N2-Sumikko/HalfCliff/doc/option_jp.md

こちらはHalfcliffのオプションの部品用の資料です。(2022/1/4時点では作成中の資料です。対応完了、と書かれたもの以外は使用不可です。)

対応を予定しているオプションの部品は以下の通りです。
設計時の制約によっては、対応を断念する可能性もあります。
* (対応完了。随時追記)ロータリーエンコーダ
* (現状は左キーボードのみ対応完了。部品は準備中)ビットトレードワン製トラックボール(ADTB7M)
* (対応完了。随時追記)OLED
* (動作確認予定)BLE Micro Pro
* (試作品作成完了)直交配列拡張基板
* (設計予定)英字配列風拡張基板
* (必要に応じて資料作成予定)右キーボードのテンキーとしての組立

# ロータリーエンコーダ
基板のフットプリントに対応しているロータリーエンコーダが使用可能です。(プッシュ機能には未対応です。)

実機にて動作確認済のものは以下の通りです。
* PEC12R-4222F-S0024(遊舎工房様等で購入可能)
* EC12E2430803(秋月電子様等で購入可能)

## 必要な部品の用意
以下の部品を用意します。

|名前|合計数|備考|
|:-|:-|:-|
|ロータリーエンコーダ|1個||
|ロータリーエンコーダ用ノブ|1個||

## 使用時の主な注意点
* 組立済みのキーボードにロータリーエンコーダを取付ける場合、取付け箇所のキースイッチを(はんだを除去して)取外す必要があります。
* ロータリーエンコーダのプッシュ機能は未対応です。
* ロータリーエンコーダ使用時は、対応するファームウェアの書込みが必要です。
* 操作時の動作を変更する際は、QMK MSYSまたはRemap、VIAを使用する必要があります。Remap、VIAを使用する場合、ロータリーエンコーダを上から見て時計回りに回転させた時の動作は、ロータリーエンコーダを取付けた列の一番上のキーと同じになります。
* (β版のみ)ロータリーエンコーダ取付け時に端子とトッププレートが干渉する場合、端子の位置や角度を干渉しないように調整するか、トッププレートの干渉部分を削る必要があります。

## 取付け方法

おおまかな作業順序
* (キースイッチはんだ付け済みの場合)ロータリーエンコーダ取付箇所のキースイッチの取外し
* ロータリーエンコーダの取付、はんだ付け(β版は注意点有り)
* (QMK Toolboxを使用する場合)ロータリーエンコーダ対応のファームウェアの書込み
* (QMK MSYSを使用する場合)ロータリーエンコーダ対応のファームウェアの書込み

## (キースイッチはんだ付け済みの場合)ロータリーエンコーダ取付箇所のキースイッチの取外し
ロータリーエンコーダ取付箇所(左右キーボード共に、一番内側の上から四番目のキーの位置)

にキースイッチがある場合は(はんだを除去して)取外します。ない場合はこの手順は飛ばします。

まずは取付を行うキーボードを裏返し、キースイッチ基板及び拡張基板をボトムプレートに固定しているねじを取外します。

左キーボードのねじ取外し箇所(黄丸で示したねじを取外します。右キーボードの場合も同じイメージです。)
ねじ取外し_ロータリーエンコーダ取付時

ねじを取外したら、キースイッチ基板と拡張基板をProMicro基板の反対方向にスライドさせて取外します。この時、ProMicro基板とキースイッチ基板を接続しているピンになるべく負荷をかけないよう注意します。

左キーボードの取外しのイメージ(水色の矢印の向きにスライドさせます。右キーボードの場合は逆方向です。)

キースイッチ基板取外し_ロータリーエンコーダ取付時

取外し後、ロータリーエンコーダ取付箇所のキースイッチのはんだをはんだ吸取機等で取り除き、取外します。

左キーボードでの取外し箇所(画像の黄丸の部分のはんだを除去し、キースイッチを取外します。右キーボードの場合も、一番内側の上から四番目のキーのはんだを同じ様に除去します。)

キースイッチ取外し箇所

## ロータリーエンコーダの取付、はんだ付け(β版の場合注意点有り)

ロータリーエンコーダを取付け、はんだ付けします。はんだ付けを行う箇所は画像の黄枠の部分です。(水色枠の部分のはんだ付けは任意です。)
ロータリーエンコーダ用はんだ付け箇所

(β版の場合)画像の様に、ロータリーエンコーダの端子(特に端子が3本ある方)とトッププレートが干渉することがあります。


その場合、トッププレートの干渉部分を削るか、ロータリーエンコーダの端子を下の画像の様に(半分より下を外側に広げるように)曲げて取付けます。


取付後の画像


## キースイッチ基板、拡張基板の再取付

取外しとは逆の手順で、キースイッチ基板とProMicro基板を接続し、キースイッチ基板と拡張基板をボトムプレートへねじ止めします。

取付後、キースイッチ基板と拡張基板を接続しているジャンパピンの状態を確認します。ピンヘッダとの接続が甘くなっていたり、外れている場合は取付け直します。

## (QMK Toolboxを使用する場合)ロータリーエンコーダ対応のファームウェアの書込み
キーボード組立時に行った
[入力動作テスト](https://github.com/N2-Sumikko/HalfCliff/blob/master/doc/Oparation_test_jp.md)
の内容を参考に、QMK ToolboxにてHexファイルを書込みます。

現時点で使用可能なロータリーエンコーダ対応のHexファイルは以下の通りです。いずれもロータリーエンコーダの機能はVIA、Remapにて変更可能です。

QMKにマージされたファームウェアを変更して作成したものは(unofficial)と記載しています。いずれも動作確認済です。(もし動作に問題があった場合はご連絡いただけると助かります。)

|フォルダ|ファイル名|概要|
|:-|:-|:-|
|hex/qmk_0.15.4/via/others/(unofficial)oled_encoder_trackball_mousekey/|halfcliff_via.hex|OLEDとロータリーエンコーダとトラックボール使用時です。|
|hex/qmk_0.15.4/via/others/(unofficial)encoder_trackball_mousekey/|halfcliff_via.hex|トラックボールとロータリーエンコーダ使用時です。|
|hex/qmk_0.15.4/via/others/(unofficial)oled_encoder/|halfcliff_via.hex|OLED、ロータリーエンコーダ使用時用です。|
|hex/qmk_0.15.4/via/others/(unofficial)encoder/|halfcliff_via.hex|ロータリーエンコーダ使用時用です。|

## (QMK MSYSを使用する場合)ロータリーエンコーダ対応のファームウェアの書込み
必要に応じて追記する予定です。

# ビットトレードワン製トラックボール(ADTB7M)
のぎけす屋様のトラックボールモジュール用レベル変換基板の使用により、ビットトレードワン製トラックボール(ADTB7M)が使用可能です。

## 必要な部品の用意
以下の部品を用意します。(トラックボールモジュール取付用キットが用意出来ていないので、現時点では参考程度の情報となります。β版を購入された方で、取付をご希望されている方がおりましたら、お手数ですがご連絡いただければと思います。)
|名前|合計数|備考|
|:-|:-|:-|
|7mmオプティカルトラックボールモジュール１uタイプ|1個|[ビット・トレード・ワン様のトラックボールモジュール(型番：ADTB7M)](https://bit-trade-one.co.jp/selfmadekb/adtb7m/)です。以下、トラックボールモジュールと呼びます。|
|トラックボールモジュール用レベル変換基板|1個|のぎけす屋様のトラックボールモジュール用レベル変換基板です。以下、変換基板と呼びます。|
|トラックボールモジュール用トッププレート|1個|トラックボールモジュール取付用キットに同梱の部品です。|
|トラックボールモジュール用ボトムプレート|1個|トラックボールモジュール取付用キットに同梱の部品です。|
|M2x6mmスペーサー|2本|トラックボールモジュール取付用キットに同梱の部品です。|
|M2x4mmスペーサー|2本|トラックボールモジュール取付用キットに同梱の部品です。|
|M2x10mmねじ|2本|トラックボールモジュール取付用キットに同梱の部品です。|
|M2x4mmねじ|2本|トラックボールモジュール取付用キットに同梱の部品です。|

トラックボールモジュール、変換基板は遊舎工房様の実店舗、[通販サイト](https://yushakobo.jp/shop/)等で購入可能です。

トラックボールモジュール取付用キットは用意出来次第、何らかの形で販売する予定です。

## 使用時の主な注意点
* キーボード組立時にキースイッチ基板にロープロファイルピンソケット1x4をはんだ付けしていない場合、トラックボールモジュールの取付は基本的に不可です。ご注意ください。
　(完全に不可能ではありませんが、とても長いピンヘッダを使用するなど、特殊な取付方法が必要です。試したら追記します。）
* halfcliffにてトラックボールを使用する場合、通常のファームウェア(本資料に記載のHexファイル)ではトラックボールを左キーボードに取付けた時のみ正しく動作します。右キーボードにトラックボールを取付けたい場合は、右キーボードへのUSBケーブル接続時に正常動作するファームウェアの書込みが必要です。(具体的には、config.hに#define MASTER_RIGHTを追記してコンパイルしたファームウェア等です。)
* トラックボールモジュールの配線及びピンヘッダを変換基板にはんだ付けする際は、各部品の向きにご注意ください。
* アクリル製の部品にスペーサーの取付けやねじ止めをする際は、強い力をかけると破損の恐れがあるのでご注意ください。

## 取付け方法

おおまかな作業順序
* (キースイッチはんだ付け済みの場合)トラックボールモジュール取付箇所のキースイッチの取外し
* 変換基板へのトラックボールモジュール配線、ピンヘッダ1x4のはんだ付け
* トラックボールモジュール用ボトムプレートの四角い穴へ変換基板の配線を通す
* トッププレートにM2x4㎜スペーサー2つをM2x10mmねじ2本で取付け
* キースイッチ基板のロープロファイルピンソケット1x4へ変換基板のピンヘッダ1x4を取付け
* M2x10mmねじへのトラックボールモジュール用ボトムプレートの取付け
* M2x6mmスペーサ2つをM2x10mmねじにねじ止めしてトラックボール用ボトムプレートを固定
* トラックボールモジュールの配線位置を調整して、トラックボールモジュール用ボトムプレートの上にトラックボールモジュールを置けるようにする
* トラックボールモジュール用トッププレートをM2x4mmねじ2本で固定
* (QMK Toolboxを使用する場合)トラックボールモジュール対応のHexファイルの書込み
* (QMK MSYSを使用する場合。ちょっと大変)トラックボールモジュール対応のファームウェアの書込み

トラックボールモジュール対応のファームウェアの内容に関しては、[こちら](https://github.com/sekigon-gonnoc/qmk_firmware/tree/dev/ble_micro_pro/keyboards/helix/rev2/keymaps/bto_tb)のせきごん様のリンクも参考になるかと思います。

## (キースイッチはんだ付け済みの場合)トラックボールモジュール取付箇所のキースイッチの取外し

トラックボール取付箇所(左右共に、一番内側の、一番上のキーの位置)

にキースイッチがある場合は(はんだを除去して)取外します。ない場合はこの手順は飛ばします。

まずは取付を行うキーボードを裏返し、キースイッチ基板、拡張基板をボトムプレートに固定しているねじを取外します。

左キーボードのねじ取外し箇所(黄丸で示したねじを取外します。)
ねじ取外し_ロータリーエンコーダ取付時

ねじを取外したら、キースイッチ基板と拡張基板をProMicro基板の反対方向にスライドさせて取外します。この時、ProMicro基板とキースイッチ基板を接続しているピンになるべく負荷をかけないよう注意します。

左キーボードの取外しのイメージ(水色の矢印の向きにスライドさせます。)

キースイッチ基板取外し_ロータリーエンコーダ取付時

取外し後、トラックボールモジュール取付箇所のキースイッチのはんだをはんだ吸取機等で取り除き、取外します。

左キーボードでの取外し箇所(黄丸の部分のはんだを除去し、キースイッチを取外します。)

トラックボール取付時のキースイッチ取外し箇所

## 変換基板へのトラックボールモジュール配線、ピンヘッダ1x4のはんだ付け

画像のように、変換基板へトラックボールモジュールの配線と、ピンヘッダ1x4をはんだ付けします。各部品の向きに注意して下さい。

言葉で説明すると、トラックボールモジュールの配線がある面を自分の方に向けて、変換基板の部品がある面を下、かつ部品が無い面の文字を自分から見て正しい向きにした状態で、部品が無い面からある面へ配線を通します。

その後、画像を参考にしながら部品がある面の長方形のパッドにそれぞれの配線をはんだ付けします。

ピンヘッダ1x4については、ピンヘッダの短い方が変換基板側、かつピンヘッダの樹脂部分が変換基板の部品がある面に来るようにして、四角形のランドにピンが入るように取付けてはんだ付けします。(四角形のランドから一番遠い丸いランドにピンが入らないようにします。)



変換基板を裏返した写真(長方形のパッドへのはんだ付け参考用)


## トラックボールモジュール用ボトムプレートの四角い穴へ変換基板の配線を通す

トラックボールモジュール用ボトムプレートの保護シートがある場合ははがします。

その後画像の様に、トラックボールモジュール用ボトムプレートの四角い穴へ、トラックボールモジュールの配線を通します。



## トッププレートにM2x4㎜スペーサー2つをM2x10mmねじ2本で取付け

画像の様に、トッププレートのU字の切り欠き2箇所に、M2x10mmねじ2本でM2x4㎜スペーサー2つを取付けます。

(説明のため、左キーボードのProMicroカバーや一部のキーキャップを取外してあります。)



## キースイッチ基板のロープロファイルピンソケット1x4へ変換基板のピンヘッダ1x4を取付け

画像の様に、キースイッチ基板のロープロファイルピンソケット1x4に、キースイッチ基板のトッププレートを介して変換基板のピンヘッダ1x4を取付けます。



## M2x10mmねじへのトラックボールモジュール用ボトムプレートの取付け

画像の様に、トラックボールモジュール用ボトムプレートの穴にM2x10mmねじ2本を通すようにして取付けます。



## M2x6mmスペーサ2つをM2x10mmねじにねじ止めしてトラックボール用ボトムプレートを固定

M2x10mmねじ2本にM2x6㎜スペーサー2つをトラックボールモジュール用ボトムプレートの上から取付け、トラックボールモジュール用ボトムプレートを固定します。



## トラックボールモジュールの配線位置を調整して、トラックボールモジュール用ボトムプレートの上にトラックボールモジュールを置けるようにする

画像を参考にトラックボールモジュールの配線位置を調整して、ボトムプレートの上にトラックボールモジュールを置けるようにします。


## トラックボールモジュール用トッププレートをM2x4mmねじ2本で固定

トラックボールモジュールの位置を調整しながら、M2x6mmスペーサ2つにトラックボールモジュール用トッププレートをM2x4mmねじ2本でねじ止めします。



## (QMK Toolboxを使用する場合)トラックボールモジュール対応のHexファイルの書込み

キーボード組立時に行った
[入力動作テスト](https://github.com/N2-Sumikko/HalfCliff/blob/master/doc/Oparation_test_jp.md)
の内容を参考に、QMK ToolboxにてHexファイルを書込みます。

現時点で使用可能なトラックボール対応のHexファイルは以下の通りです。ロータリーエンコーダ対応のファームウェアの場合、ロータリーエンコーダの機能はVIA、Remapにて変更可能です。

QMKにマージされたファームウェアを変更して作成したものは(unofficial)と記載しています。いずれも動作確認済です。

|フォルダ|ファイル名|概要|
|:-|:-|:-|
|hex/qmk_0.15.4/via/others/(unofficial)oled_encoder_trackball_mousekey/|halfcliff_via.hex|OLEDとロータリーエンコーダとトラックボール使用時です。|
|hex/qmk_0.15.4/via/others/(unofficial)encoder_trackball_mousekey/|halfcliff_via.hex|ロータリーエンコーダとトラックボール使用時です。|
|hex/qmk_0.15.4/via/others/(unofficial)trackball_mousekey/|halfcliff_via.hex|トラックボール使用時用です。|

## (QMK MSYSを使用する場合。ちょっと大変)トラックボールモジュール対応のファームウェアの作成、書込み
必要に応じて追記する予定です。(作成のパターンは、ファイルの直接変更か差替えの2パターンがあると考えています。追記する場合は、まずはファイルの差替えの手順を書く予定です。)

# OLED
対応するOLEDの取付が可能です。以下編集中の情報です。

## 必要な部品の用意
以下の部品を用意します。
|名前|合計数|備考|
|:-|:-|:-|
|OLED|2個|[こちら](https://shop.yushakobo.jp/products/oled)、または互換品が使用可能です。ただし全体の厚みに注意です。|
|ピンヘッダ1x4|1個|ピンヘッダの長さに注意が必要です。[PSH-410256-04](https://hirosugi.co.jp/products/N/PSH-41.html)等が使用可能です。|
|M2x2mm中空スペーサー|4個|halfcliffの基本セットに付属の予備のスペーサーが使用可能です。|
|M2x6mmねじ|4本||

## 使用時の主な注意点
* OLEDによっては、基板とディスプレイの間に厚い両面テープがあり、全体の厚みが増していることがあります。そのような場合、中空スペーサーを使用してもOLEDとProMicroカバーが干渉する可能性があります。対策としては、ディスプレイを割らないように気を付けながら両面テープをはがし、薄い両面テープを貼り直す等が有効です。
* OLEDを使用する場合、左右のキーボードにOLEDを取付ける必要があります。
* デフォルトの状態のOLEDにはレイヤーの状態とQMK firmwareのロゴが表示されます。表示内容を変更する場合、QMK MSYS等を使用してファームウェアを変更する必要があります。
* アクリル製の部品にスペーサーの取付けやねじ止めをする際は、強い力をかけると破損の恐れがあるのでご注意ください。

## 取付け方法

大まかな作業順序
* ProMicroカバーの取外し
* OLEDへピンヘッダ1x4のはんだ付け(注意点有り)
* ProMicro基板のロープロファイルピンソケット1x4へのOLEDの取付け、はんだ付け
* M2x2㎜中空スペーサー、ProMicroカバーをM2x6mmねじで取付
* (QMK Toolboxを使用する場合)OLED対応のHexファイルの書込み
* (QMK MSYSを使用する場合)OLED対応のファームウェアの書込み

## ProMicroカバーの取外し
ProMicroカバーを固定しているM2x4mmねじ2本を緩め、ProMicroカバーを取外します。左右のキーボードに対して同様の作業を実施します。

## OLEDへピンヘッダ1x4の取付け、はんだ付け(注意点有り)

OLEDへピンヘッダ1x4を取付け、はんだ付けします。

(注意点)ProMicro基板のロープロファイルピンソケット1x4へOLEDのピンヘッダ1x4を取付ける際には、ある程度の高さが必要です。(具体的には、OLEDの基板底面から樹脂部分含めて9㎜弱の長さが必要です。[こちら](https://hirosugi.co.jp/products/N/PSH-41.html)等が使用可能です。

## ProMicro基板のロープロファイルピンソケット1x4へのOLEDの取付け

ProMicro基板のロープロファイルピンソケット1x4へ、OLEDにはんだ付けしたピンヘッダ1x4を取付けます。

## M2x2㎜中空スペーサー、ProMicroカバーをM2x6mmねじで取付

ProMicro基板を固定していたM2x7mmスペーサー2つの上にM2x2mm中空スペーサーをそれぞれ置きます。左右のキーボードに対して同様の作業を実施します。

(画像はトラックボール、ロータリーエンコーダを取付けした状態の左キーボードです。)


その後、M2x6mmねじ2本を、ProMicroカバー、中空スペーサーの穴の順に通してM2x7mmスペーサーへねじ止めします。



## (QMK Toolboxを使用する場合))OLED対応のHexファイルの書込み
キーボード組立時に行った
[入力動作テスト](https://github.com/N2-Sumikko/HalfCliff/blob/master/doc/Oparation_test_jp.md)
の内容を参考に、QMK ToolboxにてHexファイルを書込みます。

現在使用可能なOLED対応のHexファイルは以下の通りです。ロータリーエンコーダ対応のファームウェアの場合、ロータリーエンコーダの機能はVIA、Remapにて変更可能です。

QMKにマージされたファームウェアを変更して作成したものは(unofficial)と記載しています。いずれも動作確認済です。

|フォルダ|ファイル名|概要|
|:-|:-|:-|
|hex/qmk_0.15.4/via/others/(unofficial)oled_encoder_trackball_mousekey/|halfcliff_via.hex|OLEDとロータリーエンコーダとトラックボール使用時です。|
|hex/qmk_0.15.4/via/others/(unofficial)oled_trackball_mousekey/|halfcliff_via.hex|OLED、トラックボール使用時です。|
|hex/qmk_0.15.4/via/others/(unofficial)oled_encoder/|halfcliff_via.hex|OLEDとロータリーエンコーダ使用時用です。|
|hex/qmk_0.15.4/via/others/(unofficial)oled/|halfcliff_via.hex|OLED使用時用です。|

## (QMK MSYSを使用する場合)OLED対応のファームウェアの書込み
必要に応じて追記する予定です。
