N2-Sumikko/HalfCliff/data/plate/dxf/promicro_coverplate.dxf

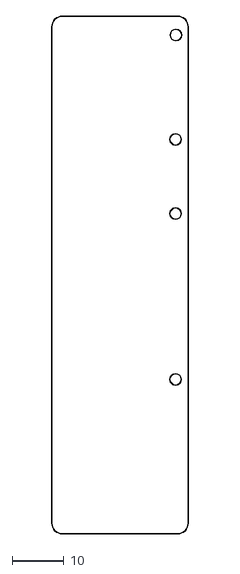
[picture p1: CAD file, 2021-07-04]
data/plate/dxf/promicro_coverplate.dxf
26.3 x 100.0
