N2-Sumikko/HalfCliff/data/plate/dxf/bottomplate_jis_left.dxf

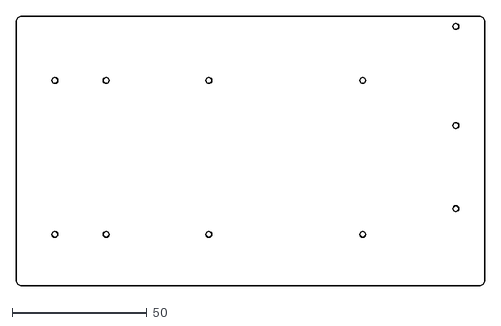
[picture p2: CAD file, 2021-07-04]
data/plate/dxf/bottomplate_jis_left.dxf
173.9 x 100.0
