N2-Sumikko/HalfCliff/data/plate/dxf/bottomplate_minimum.dxf

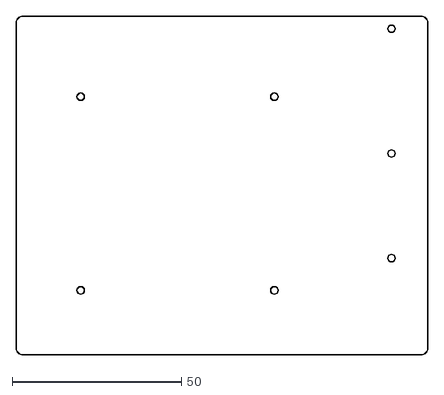
[picture p3: CAD file, 2021-07-04]
data/plate/dxf/bottomplate_minimum.dxf
121.5 x 100.0
