N2-Sumikko/HalfCliff/data/plate/dxf/bottomplate_jis_right.dxf

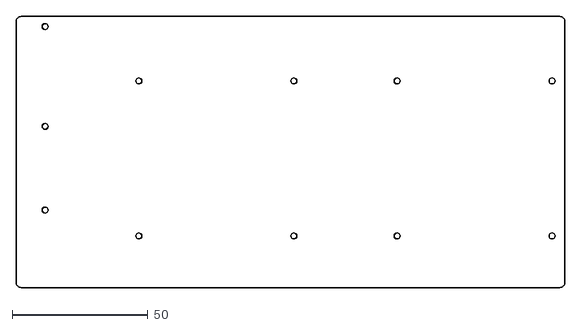
[picture p4: CAD file, 2021-07-04]
data/plate/dxf/bottomplate_jis_right.dxf
202.5 x 100.0
